TurdiyevIslombek/fly-brain-car/esp32cam/camera_stream/wifi_settings.example.h

// Copy to wifi_settings.h (or run: python3 tools/write_wifi.py "WiFi name" "password").
// wifi_settings.h is git-ignored so a real WiFi password never gets published.
// Empty WIFI_NAME = the camera makes its own WiFi (AP_NAME).
#define WIFI_NAME ""
#define WIFI_PASSWORD ""
#define AP_NAME "FlyCar-CAM"
#define AP_PASSWORD "change-me-123"
